Meigs2/Axis/README.md

# Axis

This project is unfinished and is under active development.

For updates, come join the discord: https://discord.gg/SSdEUZB4Xh
