Meigs2/Axis/hardware/pcbs/Axis_Base_Rev01/Axis_Base_Rev01.kicad_pcb

## KiCad design hardware/pcbs/Axis_Base_Rev01/Axis_Base_Rev01.kicad_pcb (2025-01-05)

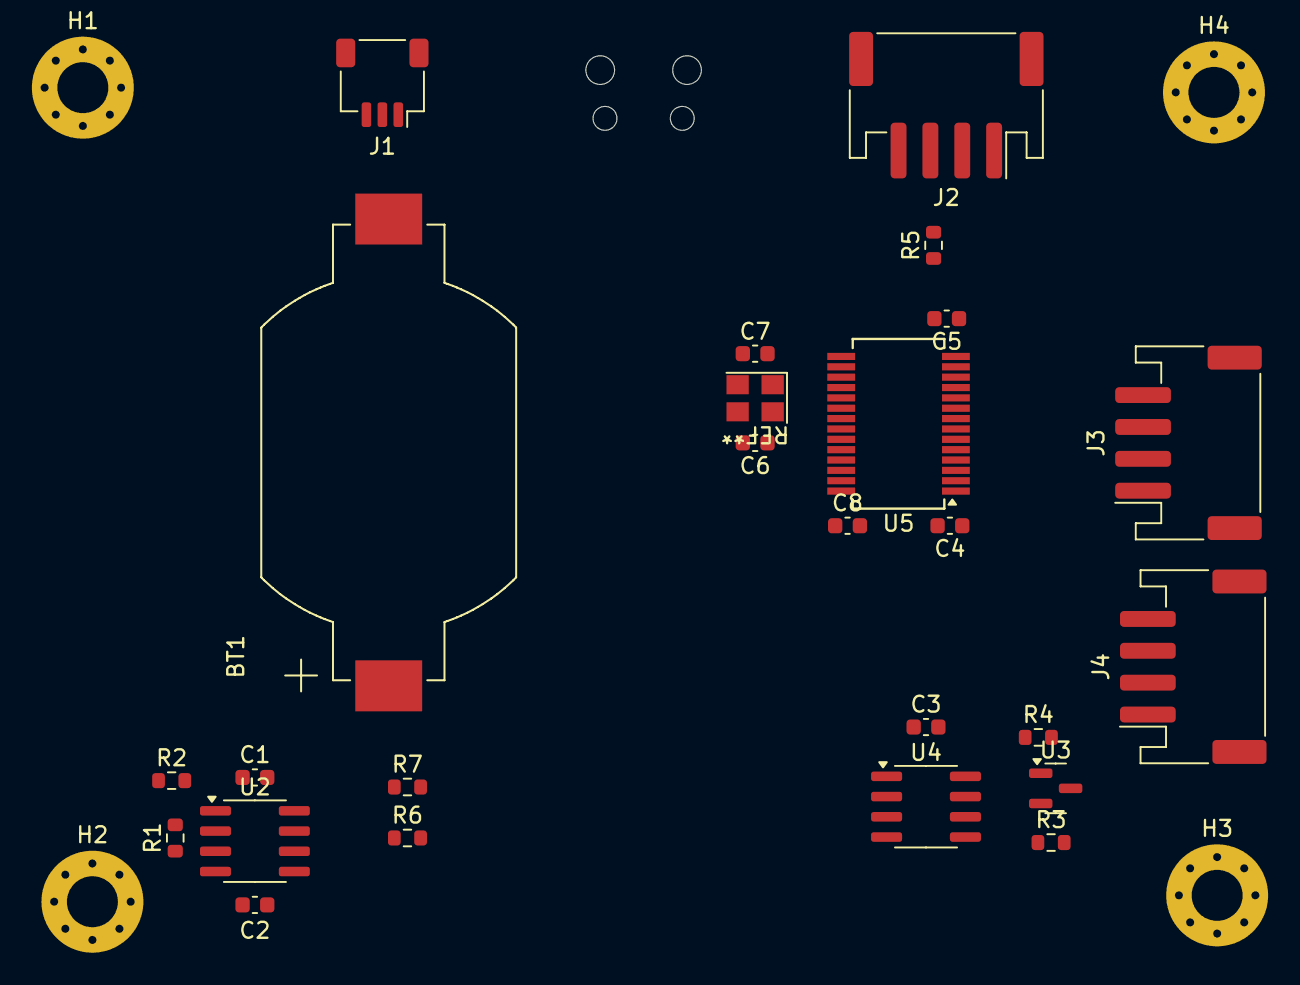
[picture p1: board Axis_Base_Rev01.kicad_pcb from above]

Board: 4 copper layers, 30 parts (1 on the bottom side), 28 nets, no tracks yet.

Parts:
BT1: BA2032; BAT_BU2032SM-BT-GTR
C1, C2, C3, C4, C5, C8: 0.1u; C_0603_1608Metric
C6, C7: 26p; C_0603_1608Metric
H1, H2, H3, H4: MountingHole; MountingHole_3.2mm_M3_Pad_Via
J1: SWD; JST_SH_SM03B-SRSS-TB_1x03-1MP_P1.00mm_Horizontal
J2: CAN_1; JST_PH_S4B-PH-SM4-TB_1x04-1MP_P2.00mm_Horizontal
J3: CAN_2; JST_PH_S4B-PH-SM4-TB_1x04-1MP_P2.00mm_Horizontal
J4: CAN_3; JST_PH_S4B-PH-SM4-TB_1x04-1MP_P2.00mm_Horizontal
R1, R2, R3, R4, R5, R6, R7: 1k; R_0603_1608Metric
U1: Pico; RPi_Pico_SMD_No_Silkscreen
U2: DS3231MZ; SOIC-8_3.9x4.9mm_P1.27mm
U3: DS2411R; SOT-23
U4: FM24CL16B; SOIC-8_3.9x4.9mm_P1.27mm
U5: MCP251863T-H; SSOP-28_5.3x10.2mm_P0.65mm
Y1: ABM8G-20.000MHZ-18-D2Y-T; Oscillator_Crystal_Abracon_SMD_ABM8G

Connections:
+3V3: C1.1, C3.1, C4.1, C5.1, R1.1, R2.1, R3.1, R6.1, R7.1, U1.36 (3V3_OUT), U2.2 (VCC), U3.2 (VIN), U4.8 (VDD), U5.1 (VIO), U5.14 (VDD)
+5V: C8.1, J2.1, J3.1, J4.1, U1.40 (VBUS), U5.25 (VCC)
+BATT: BT1.1 (+), C2.1, U2.6 (VBAT)
/1WIRE: R4.2, U1.26 (GPIO20)
/CANH: J2.2, J3.2, J4.2, R5.1, U5.4 (CANH)
/CANL: J2.3, J3.3, J4.3, R5.2, U5.3 (CANL)
/I2C0_SCL: R7.2, U1.22 (GPIO17), U2.8 (SCL), U4.6 (SCL)
/I2C0_SDA: R6.2, U1.21 (GPIO16), U2.7 (SDA), U4.5 (SDA)
/RTC_CLK: R1.2, U1.24 (GPIO18), U2.1 (32KHZ)
/SPI0_MISO: U1.1 (GPIO0), U5.11 (SDO)
/SPI0_MOSI: U1.5 (GPIO3), U5.10 (SDI)
/SPI0_SCK: U1.4 (GPIO2), U5.9 (SCK)
/STBY: U1.10 (GPIO7), U5.5 (STBY)
/SWCLK: J1.1, U1.41 (SWCLK)
/SWDIO: J1.3, U1.43 (SWDIO)
/~SPI0_CS: U1.2 (GPIO1), U5.13 (~CS)
/~TIMER_INT: R2.2, U1.25 (GPIO19), U2.3 (~INT/SQW)
/~nINT1: U1.7 (GPIO5), U5.6 (~nINT1)
/~nINT2: U1.9 (GPIO6), U5.7 (~nINT2)
/~nINT: U1.6 (GPIO4), U5.19 (~nINT)
GND: BT1.2 (-), C1.2, C2.2, C3.2, C4.2, C5.2, C8.2, J1.2, J2.4, J3.4, J4.4, U1.3 (GND), U1.8 (GND), U1.13 (GND), U1.18 (GND), U1.23 (GND), U1.28 (GND), U1.38 (GND), U1.42 (GND), U2.5 (GND), U3.3 (GND), U4.4 (VSS), U4.7 (WP), U5.22 (VSS), U5.24 (GND), Y1.1, Y1.3
unnamed: C6.2, Y1.4
unnamed: C7.2, Y1.2
unnamed: R3.2, R4.1, U3.1 (I/O)
unnamed: C7.1, U5.21 (OSC1)
unnamed: C6.1, U5.20 (OSC2)
unnamed: U5.16 (RxCAN), U5.28 (RXD)
unnamed: U5.15 (TxCAN), U5.23 (TXD)
