Meigs2/Axis/hardware/pcbs/Hats/Gaggia/Axis_GCP_Hat_Rev1/Axis_GCP_Hat_Rev1.kicad_pcb

## KiCad design hardware/pcbs/Hats/Gaggia/Axis_GCP_Hat_Rev1/Axis_GCP_Hat_Rev1.kicad_pcb (2024-10-21)

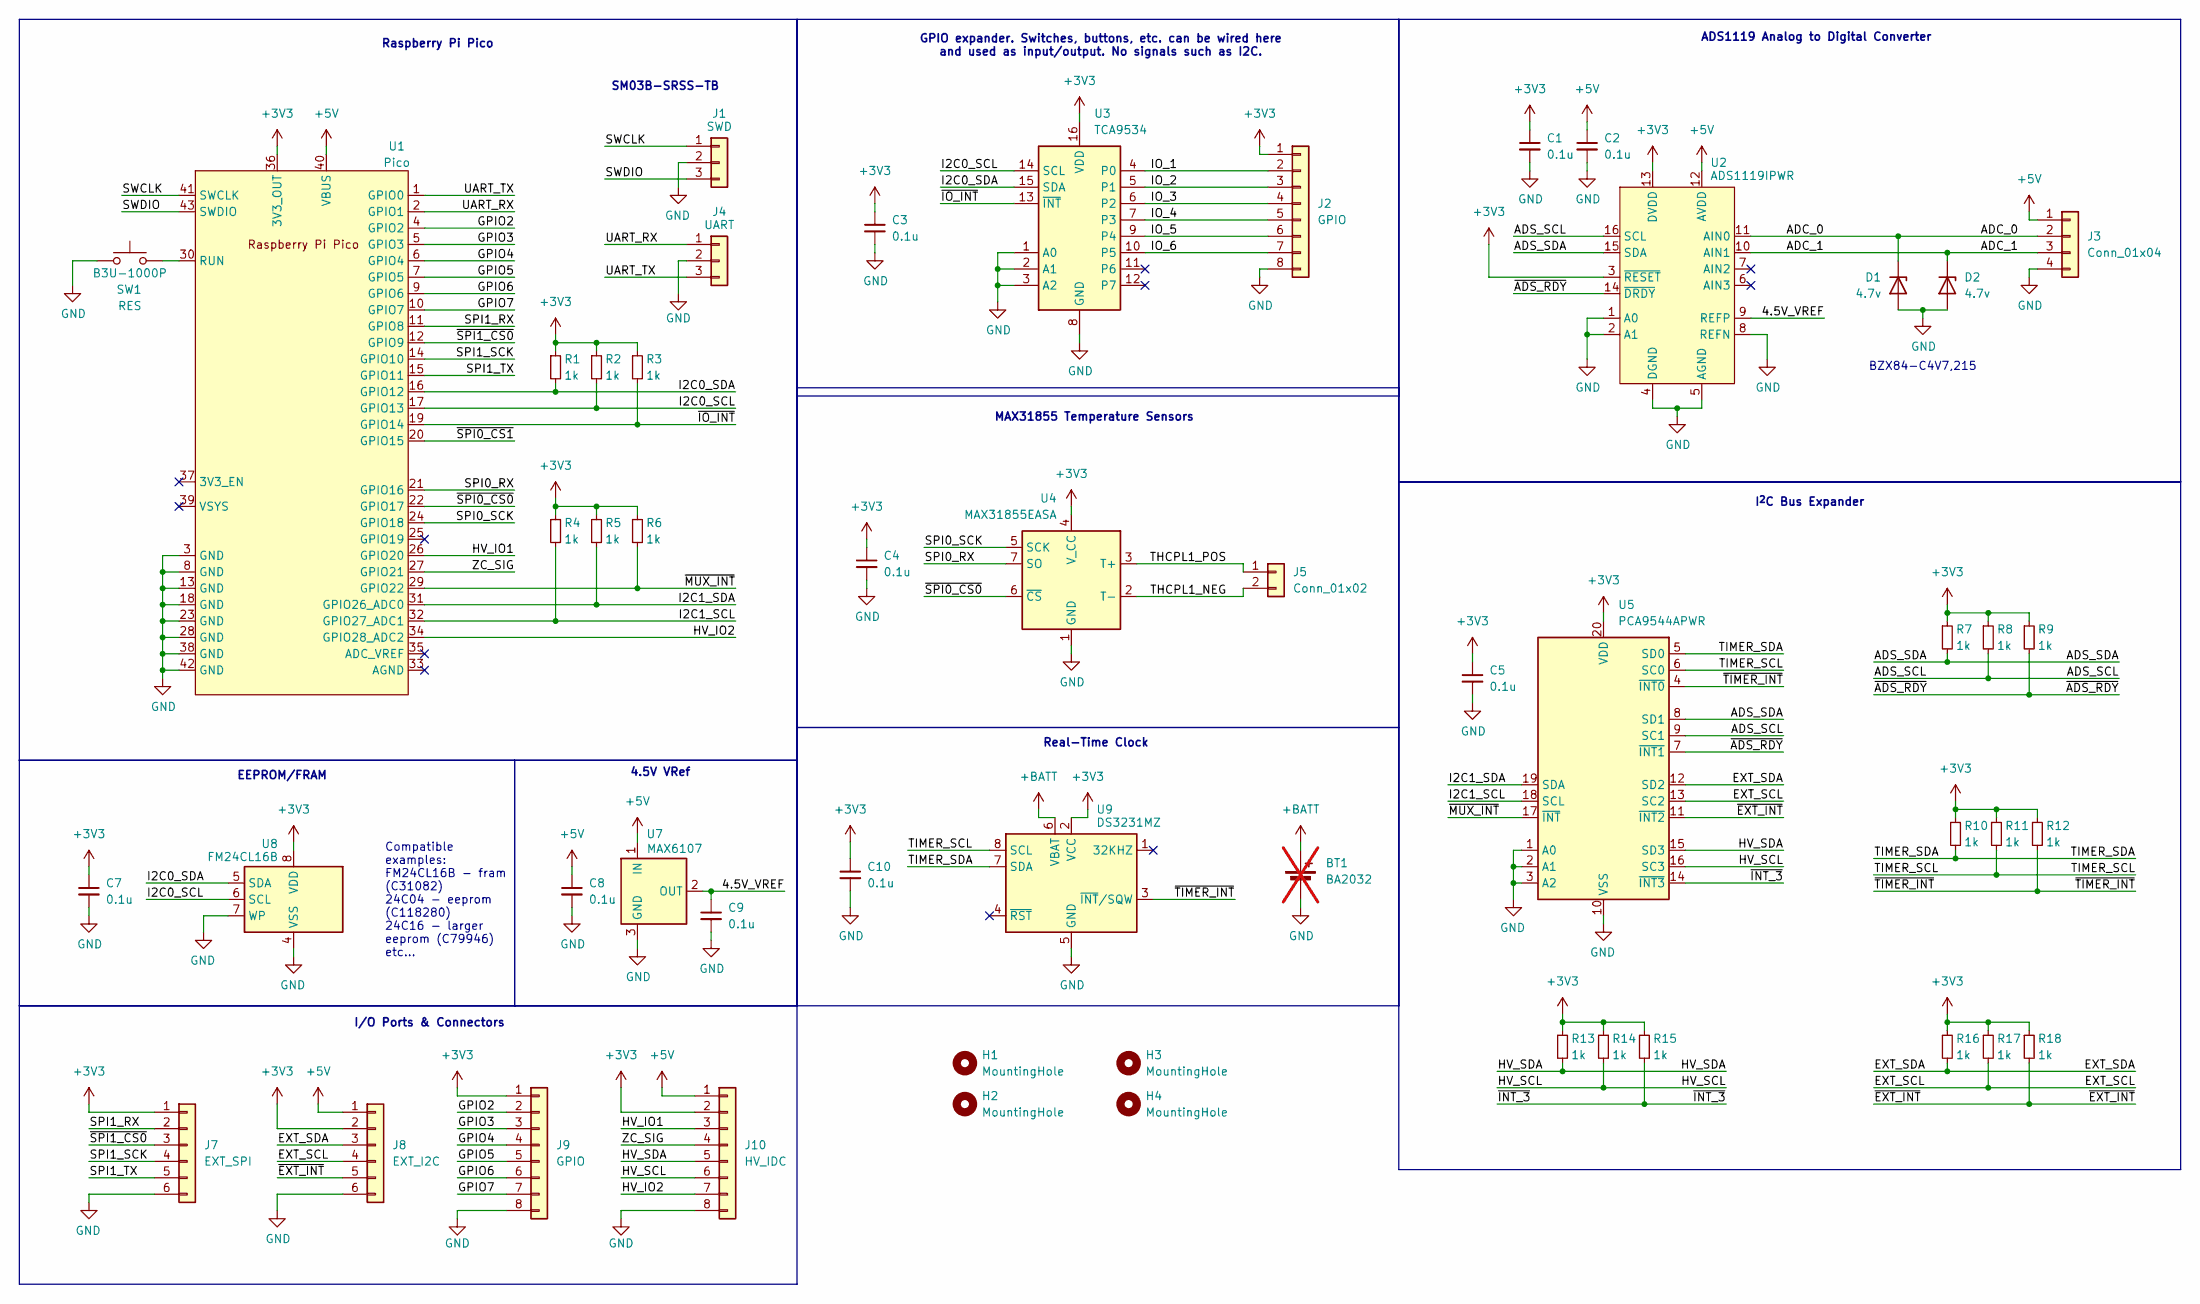
[picture p2: schematic Axis_GCP_Hat_Rev1.kicad_sch, Axis Control PCB]

Parts:
BT1: BA2032; not fitted
C1, C2, C3, C4, C5, C7, C8, C9, C10: 0.1u; C_0402_1005Metric
D1, D2: 4.7v; SOT-23
H1, H2, H3, H4: MountingHole; MountingHole_2.7mm_M2.5
J1: SWD; JST_SH_SM03B-SRSS-TB_1x03-1MP_P1.00mm_Horizontal
J2: GPIO; TerminalBlock_Phoenix_MKDS-1,5-8-5.08_1x08_P5.08mm_Horizont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
J3: Conn_01x04; TerminalBlock_Phoenix_MKDS-1,5-4-5.08_1x04_P5.08mm_Horizont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
J4: UART; JST_SH_SM03B-SRSS-TB_1x03-1MP_P1.00mm_Horizontal
J5: Conn_01x02; TerminalBlock_Phoenix_MKDS-1,5-2-5.08_1x02_P5.08mm_Horizont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
J7: EXT_SPI; PinHeader_1x06_P2.54mm_Vertical
J8: EXT_I2C; PinHeader_1x06_P2.54mm_Vertical
J9: GPIO; PinHeader_1x08_P2.54mm_Vertical
J10: HV_IDC; IDC-Header_2x04_P2.54mm_Vertical
R1, R2, R3, R4, R5, R6, R7, R8, R9, R10, R11, R12, R13, R14, R15, R16, R17, R18: 1k; R_0402_1005Metric
SW1: RES; SW_SPST_B3U-1000P; LCSC C231329
U1: Pico; RPi_Pico_SMD_TH_No_Silkscreen
U2: ADS1119IPWR; TSSOP-16_4.4x5mm_P0.65mm
U3: TCA9534; TSSOP-16_4.4x5mm_P0.65mm
U4: MAX31855EASA; SOIC-8_3.9x4.9mm_P1.27mm
U5: PCA9544APWR; TSSOP-20_4.4x6.5mm_P0.65mm
U7: MAX6107; SOT-23
U8: FM24CL16B; SOIC-8_3.9x4.9mm_P1.27mm; LCSC C31082
U9: DS3231MZ; SOIC-8_3.9x4.9mm_P1.27mm

Connections:
+3V3: C1.1, C3.1, C4.1, C5.1, C7.1, C10.1, J2.1, J7.1, J8.2, J9.1, J10.2, R1.1, R2.1, R3.1, R4.1, R5.1, R6.1, R7.1, R8.1, R9.1, R10.1, R11.1, R12.1, R13.1, R14.1, R15.1, R16.1, R17.1, R18.1, U1.36 (3V3_OUT), U2.3 (~RESET), U2.13 (DVDD), U3.16 (VDD), U4.4 (V_CC), U5.20 (VDD), U8.8 (VDD), U9.2 (VCC)
+5V: C2.1, C8.1, J3.1, J8.1, J10.1, U1.40 (VBUS), U2.12 (AVDD), U7.1 (IN)
+BATT: BT1.1 (+), U9.6 (VBAT)
/4.5V_VREF: C9.1, U2.9 (REFP), U7.2 (OUT)
/ADC_0: D1.1 (K), J3.2, U2.11 (AIN0)
/ADC_1: D2.1 (K), J3.3, U2.10 (AIN1)
/ADS_SCL: R8.2, U2.16 (SCL), U5.9 (SC1)
/ADS_SDA: R7.2, U2.15 (SDA), U5.8 (SD1)
/EXT_SCL: J8.4, R17.2, U5.13 (SC2)
/EXT_SDA: J8.3, R16.2, U5.12 (SD2)
/GPIO2: J9.2, U1.4 (GPIO2)
/GPIO3: J9.3, U1.5 (GPIO3)
/GPIO4: J9.4, U1.6 (GPIO4)
/GPIO5: J9.5, U1.7 (GPIO5)
/GPIO6: J9.6, U1.9 (GPIO6)
/GPIO7: J9.7, U1.10 (GPIO7)
/HV_IO1: J10.3, U1.26 (GPIO20)
/HV_IO2: J10.7, U1.34 (GPIO28_ADC2)
/HV_SCL: J10.6, R14.2, U5.16 (SC3)
/HV_SDA: J10.5, R13.2, U5.15 (SD3)
/I2C0_SCL: R2.2, U1.17 (GPIO13), U3.14 (SCL), U8.6 (SCL)
/I2C0_SDA: R1.2, U1.16 (GPIO12), U3.15 (SDA), U8.5 (SDA)
/I2C1_SCL: R4.2, U1.32 (GPIO27_ADC1), U5.18 (SCL)
/I2C1_SDA: R5.2, U1.31 (GPIO26_ADC0), U5.19 (SDA)
/IO_1: J2.2, U3.4 (P0)
/IO_2: J2.3, U3.5 (P1)
/IO_3: J2.4, U3.6 (P2)
/IO_4: J2.5, U3.7 (P3)
/IO_5: J2.6, U3.9 (P4)
/IO_6: J2.7, U3.10 (P5)
/SPI0_RX: U1.21 (GPIO16), U4.7 (SO)
/SPI0_SCK: U1.24 (GPIO18), U4.5 (SCK)
/SPI1_RX: J7.2, U1.11 (GPIO8)
/SPI1_SCK: J7.4, U1.14 (GPIO10)
/SPI1_TX: J7.5, U1.15 (GPIO11)
/SWCLK: J1.1, U1.41 (SWCLK)
/SWDIO: J1.3, U1.43 (SWDIO)
/THCPL1_NEG: J5.2, U4.2 (T-)
/THCPL1_POS: J5.1, U4.3 (T+)
/TIMER_SCL: R11.2, U5.6 (SC0), U9.8 (SCL)
/TIMER_SDA: R10.2, U5.5 (SD0), U9.7 (SDA)
/UART_RX: J4.1, U1.2 (GPIO1)
/UART_TX: J4.3, U1.1 (GPIO0)
/ZC_SIG: J10.4, U1.27 (GPIO21)
/~ADS_RDY: R9.2, U2.14 (~DRDY), U5.7 (~INT1)
/~EXT_INT: J8.5, R18.2, U5.11 (~INT2)
/~INT_3: R15.2, U5.14 (~INT3)
/~IO_INT: R3.2, U1.19 (GPIO14), U3.13 (~INT)
/~MUX_INT: R6.2, U1.29 (GPIO22), U5.17 (~INT)
/~SPI0_CS0: U1.22 (GPIO17), U4.6 (~CS)
/~SPI0_CS1: U1.20 (GPIO15)
/~SPI1_CS0: J7.3, U1.12 (GPIO9)
/~TIMER_INT: R12.2, U5.4 (~INT0), U9.3 (~INT/SQW)
GND: BT1.2 (-), C1.2, C2.2, C3.2, C4.2, C5.2, C7.2, C8.2, C9.2, C10.2, D1.2 (A), D2.2 (A), J1.2, J2.8, J3.4, J4.2, J7.6, J8.6, J9.8, J10.8, SW1.1, U1.3 (GND), U1.8 (GND), U1.13 (GND), U1.18 (GND), U1.23 (GND), U1.28 (GND), U1.38 (GND), U1.42 (GND), U2.1 (A0), U2.2 (A1), U2.4 (DGND), U2.5 (AGND), U2.8 (REFN), U3.1 (A0), U3.2 (A1), U3.3 (A2), U3.8 (GND), U4.1 (GND), U5.1 (A0), U5.2 (A1), U5.3 (A2), U5.10 (VSS), U7.3 (GND), U8.4 (VSS), U8.7 (WP), U9.5 (GND)
unnamed: SW1.2, U1.30 (RUN)

Notes on the sheet:
BZX84-C4V7,215
I^{2}C Bus Expander
I/O Ports & Connectors
Raspberry Pi Pico
Compatible examples: FM24CL16B - fram (C31082) 24C04 - eeprom (C118280) 24C16 - larger eeprom (C79946) etc...
EEPROM/FRAM
ADS1119 Analog to Digital Converter
Real-Time Clock
MAX31855 Temperature Sensors
GPIO expander. Switches, buttons, etc. can be wired here and used as input/output. No signals such as I2C.
4.5V VRef
SM03B-SRSS-TB

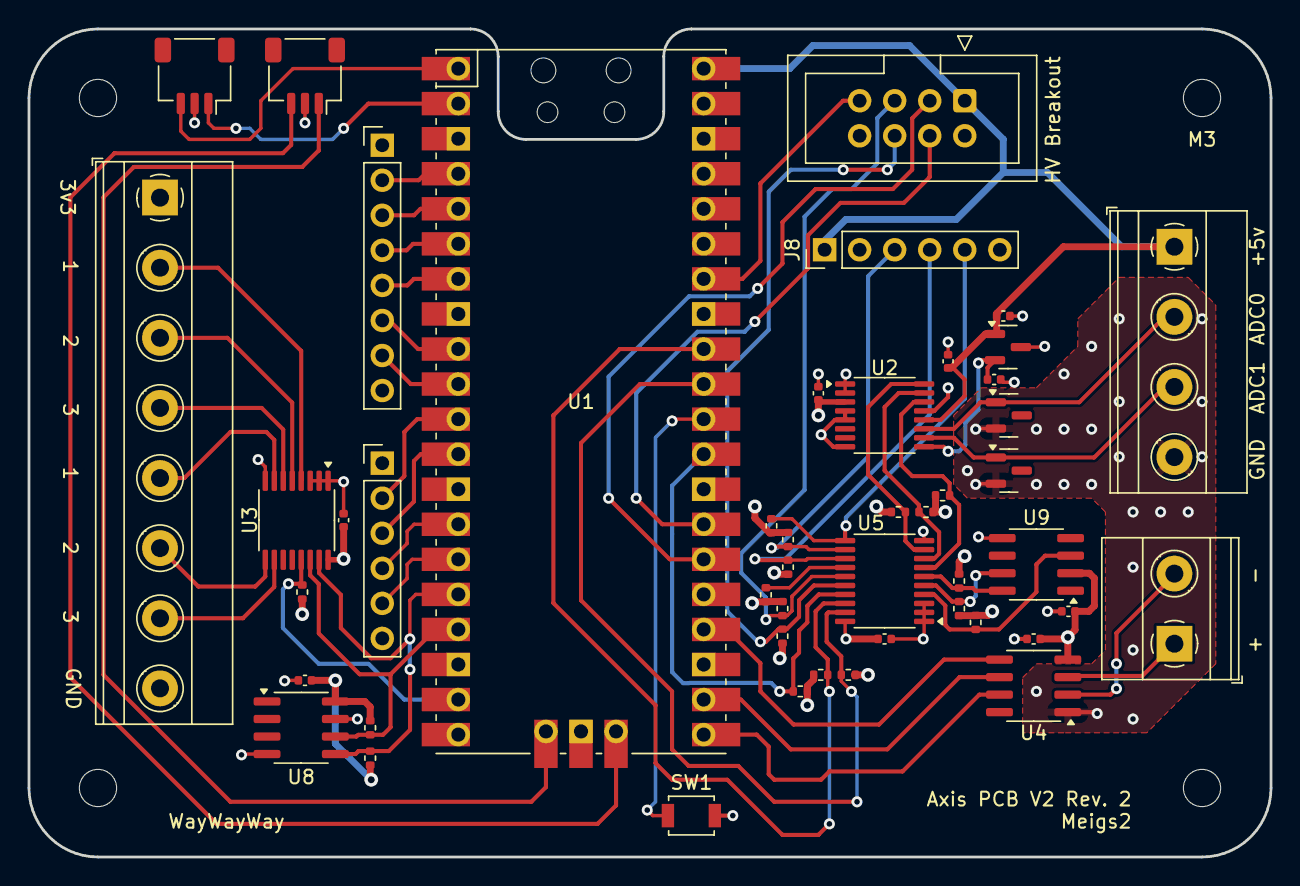
[picture p3: board Axis_GCP_Hat_Rev1.kicad_pcb from above]

Board: 4 copper layers, 90.0 x 60.0 mm, 51 parts (0 on the bottom side), 53 nets.
