Meigs2/Axis/hardware/pcbs/Axis_V2_HV/Axis_V2_HV.kicad_pcb

## KiCad design hardware/pcbs/Axis_V2_HV/Axis_V2_HV.kicad_pcb (2024-10-12)

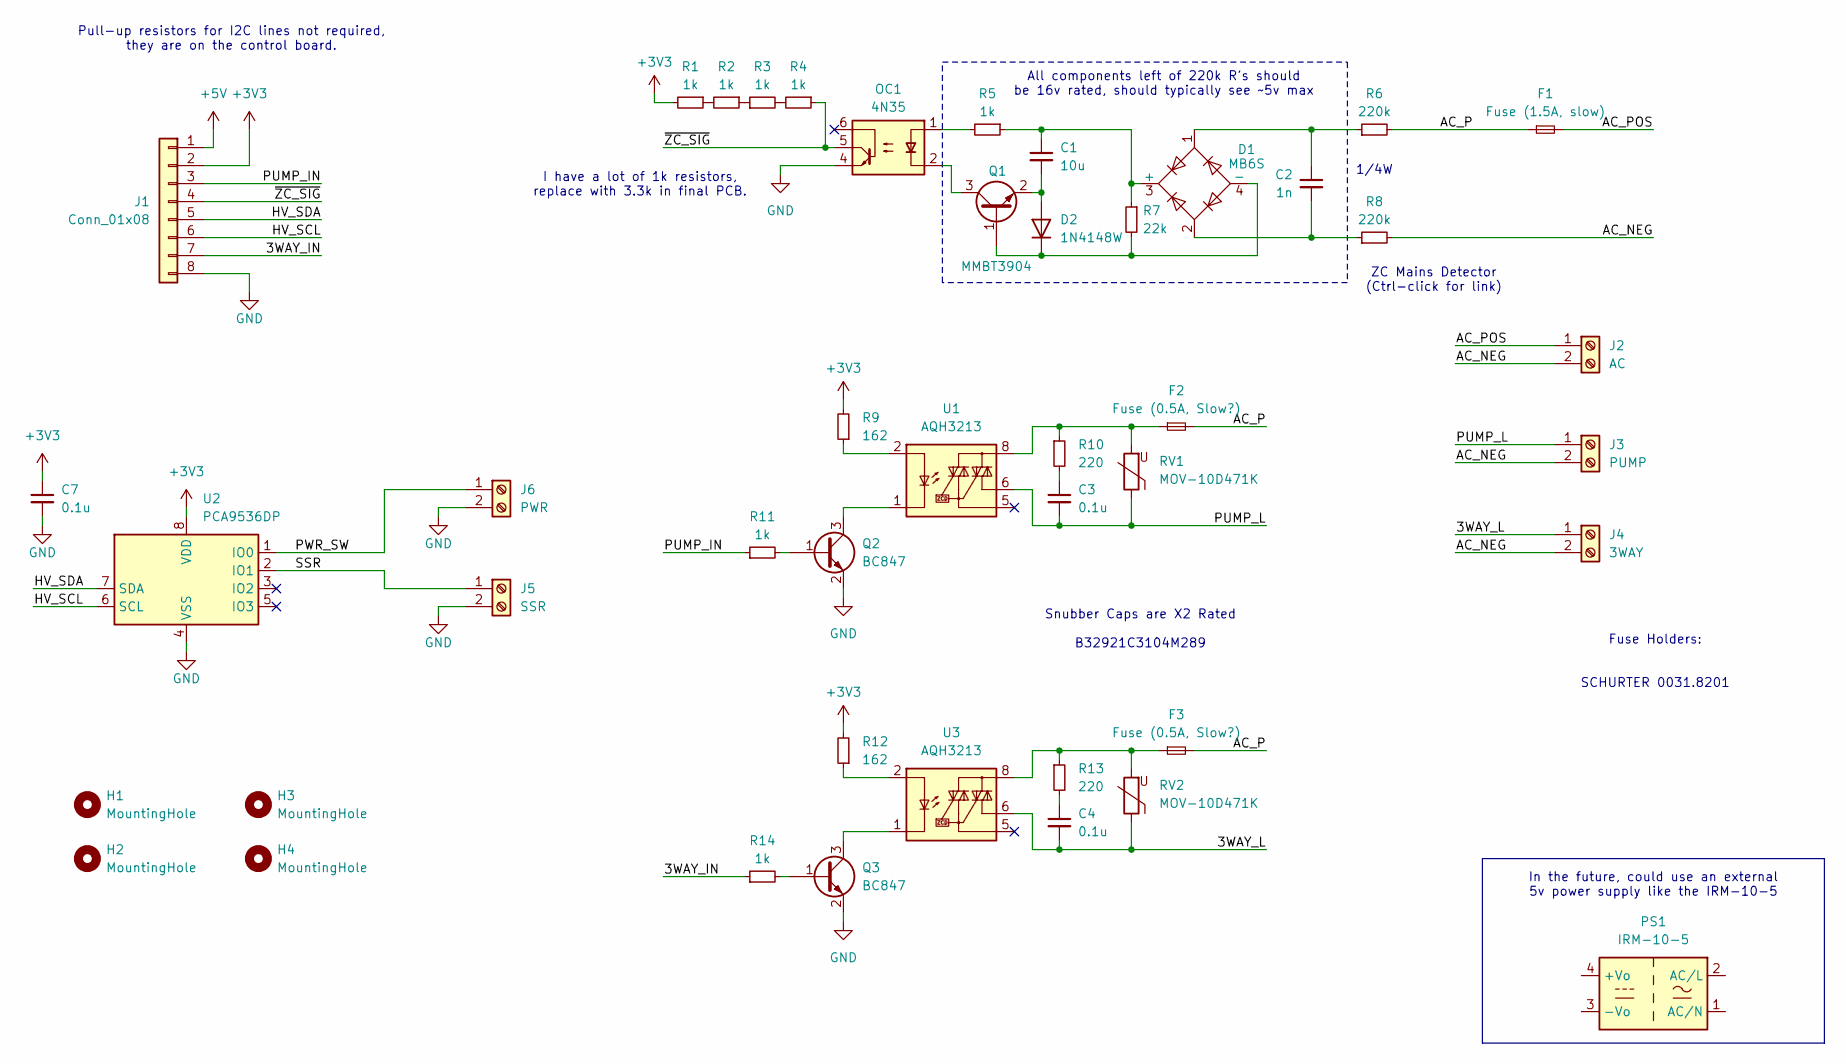
[picture p4: schematic Axis_V2_HV.kicad_sch]

Parts:
C1: 10u; C_1206_3216Metric
C2: 1n; C_1206_3216Metric
C3, C4: 0.1u; C_Rect_L13.0mm_W6.0mm_P10.00mm_FKS3_FKP3_MKS4
C7: 0.1u; C_0402_1005Metric
D1: MB6S; TO-269AA
D2: 1N4148W; D_SOD-123
F1: Fuse (1.5A, slow); Fuseholder_Cylinder-5x20mm_Schurter_0031_8201_Horizontal_Op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
F2, F3: Fuse (0.5A, Slow?); Fuseholder_Cylinder-5x20mm_Schurter_0031_8201_Horizontal_Op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
H1, H2, H3, H4: MountingHole; MountingHole_2.7mm_M2.5
J1: Conn_01x08; IDC-Header_2x04_P2.54mm_Vertical
J2: AC; TerminalBlock_Phoenix_MKDS-1,5-2-5.08_1x02_P5.08mm_Horizont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
J3: PUMP; TerminalBlock_Phoenix_MKDS-1,5-2-5.08_1x02_P5.08mm_Horizont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
J4: 3WAY; TerminalBlock_Phoenix_MKDS-1,5-2-5.08_1x02_P5.08mm_Horizont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
J5: SSR; TerminalBlock_Phoenix_MKDS-1,5-2-5.08_1x02_P5.08mm_Horizont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
J6: PWR; TerminalBlock_Phoenix_MKDS-1,5-2-5.08_1x02_P5.08mm_Horizont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
OC1: 4N35; SMDIP-6_W7.62mm
PS1: IRM-10-5; Converter_ACDC_MeanWell_IRM-10-xx_THT
Q1: MMBT3904; SOT-23
Q2, Q3: BC847; SOT-23
R1, R2, R3, R4, R11, R14: 1k; R_0402_1005Metric
R5: 1k; R_1206_3216Metric
R6, R8: 220k; R_Axial_DIN0207_L6.3mm_D2.5mm_P10.16mm_Horizontal
R7: 22k; R_1206_3216Metric
R9, R12: 162; R_0603_1608Metric
R10, R13: 220; R_Axial_DIN0207_L6.3mm_D2.5mm_P10.16mm_Horizontal
RV1, RV2: MOV-10D471K; RV_Disc_D12mm_W7.5mm_P7.5mm
U1, U3: AQH3213; DIP-8-N7_W7.62mm
U2: PCA9536DP; TSSOP-8_3x3mm_P0.65mm

Connections:
+3V3: C7.1, J1.2, R1.2, R9.2, R12.2, U2.8 (VDD)
+5V: J1.1
/3WAY_IN: J1.7, R14.1
/3WAY_L: C4.2, J4.1, RV2.1, U3.6
/AC_NEG: J2.2, J3.2, J4.2, R8.2
/AC_P: F1.1, F2.2, F3.2, R6.2
/AC_POS: F1.2, J2.1
/HV_SCL: J1.6, U2.6 (SCL)
/HV_SDA: J1.5, U2.7 (SDA)
/PUMP_IN: J1.3, R11.1
/PUMP_L: C3.2, J3.1, RV1.1, U1.6
/PWR_SW: J6.1, U2.1 (IO0)
/SSR: J5.1, U2.2 (IO1)
/~ZC_SIG: J1.4, OC1.5, R4.1
GND: C7.2, J1.8, J5.2, J6.2, OC1.4, Q2.2 (E), Q3.2 (E), U2.4 (VSS)
unnamed: C2.1, D1.1, R6.1
unnamed: C2.2, D1.2, R8.1
unnamed: C3.1, R10.2
unnamed: C4.1, R13.2
unnamed: C1.1, D1.3 (+), R5.1, R7.1
unnamed: D1.4 (-), D2.1 (K), Q1.1 (B), R7.2
unnamed: C1.2, D2.2 (A), Q1.2 (E)
unnamed: F2.1, R10.1, RV1.2, U1.8
unnamed: F3.1, R13.1, RV2.2, U3.8
unnamed: OC1.1, R5.2
unnamed: OC1.2, Q1.3 (C)
unnamed: Q2.1 (B), R11.2
unnamed: Q2.3 (C), U1.1, U1.3, U1.4
unnamed: Q3.1 (B), R14.2
unnamed: Q3.3 (C), U3.1, U3.3, U3.4
unnamed: R1.1, R2.2
unnamed: R2.1, R3.1
unnamed: R3.2, R4.2
unnamed: R9.1, U1.2
unnamed: R12.1, U3.2

Notes on the sheet:
Pull-up resistors for I2C lines not required, they are on the control board.
I have a lot of 1k resistors, replace with 3.3k in final PCB.
ZC Mains Detector (Ctrl-click for link)
1/4W
In the future, could use an external 5v power supply like the IRM-10-5
All components left of 220k R's should be 16v rated, should typically see ~5v max
Fuse Holders: SCHURTER 0031.8201
Snubber Caps are X2 Rated B32921C3104M289

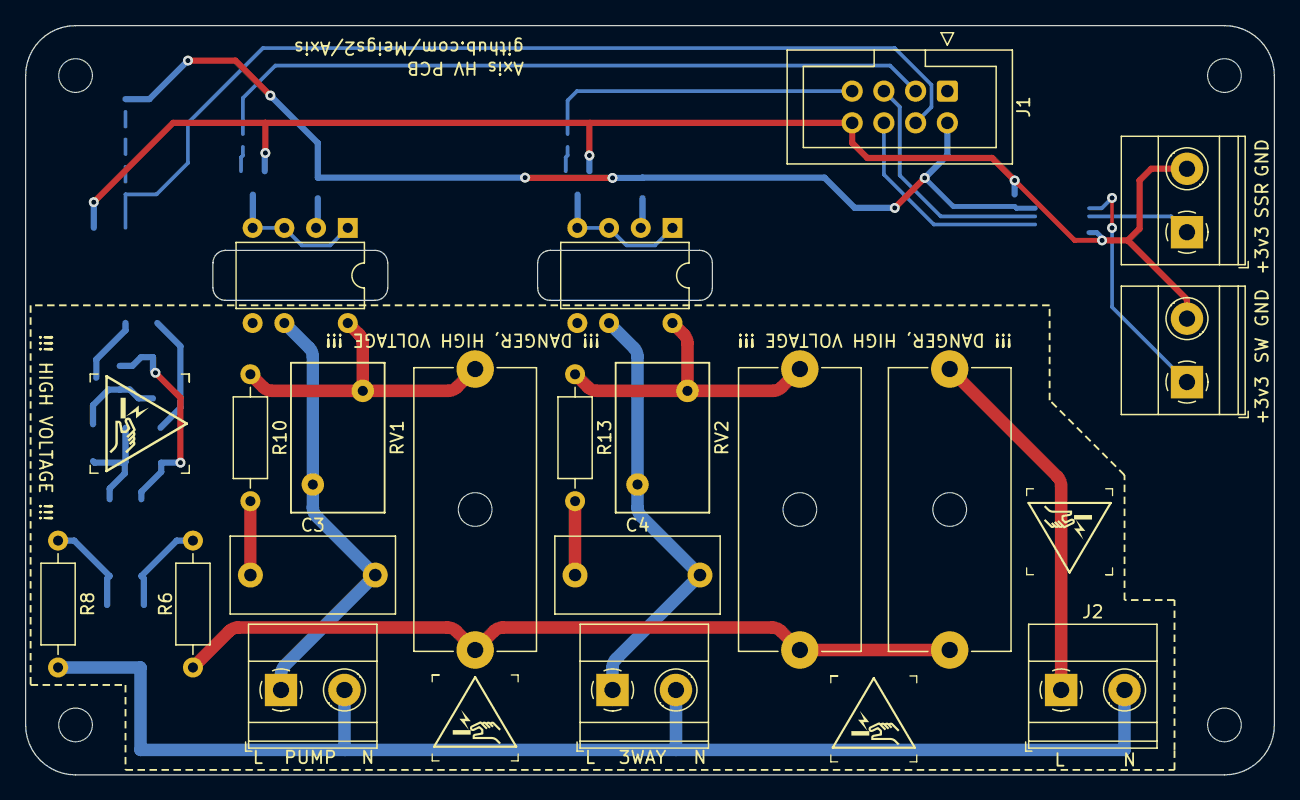
[picture p5: board Axis_V2_HV.kicad_pcb from above]

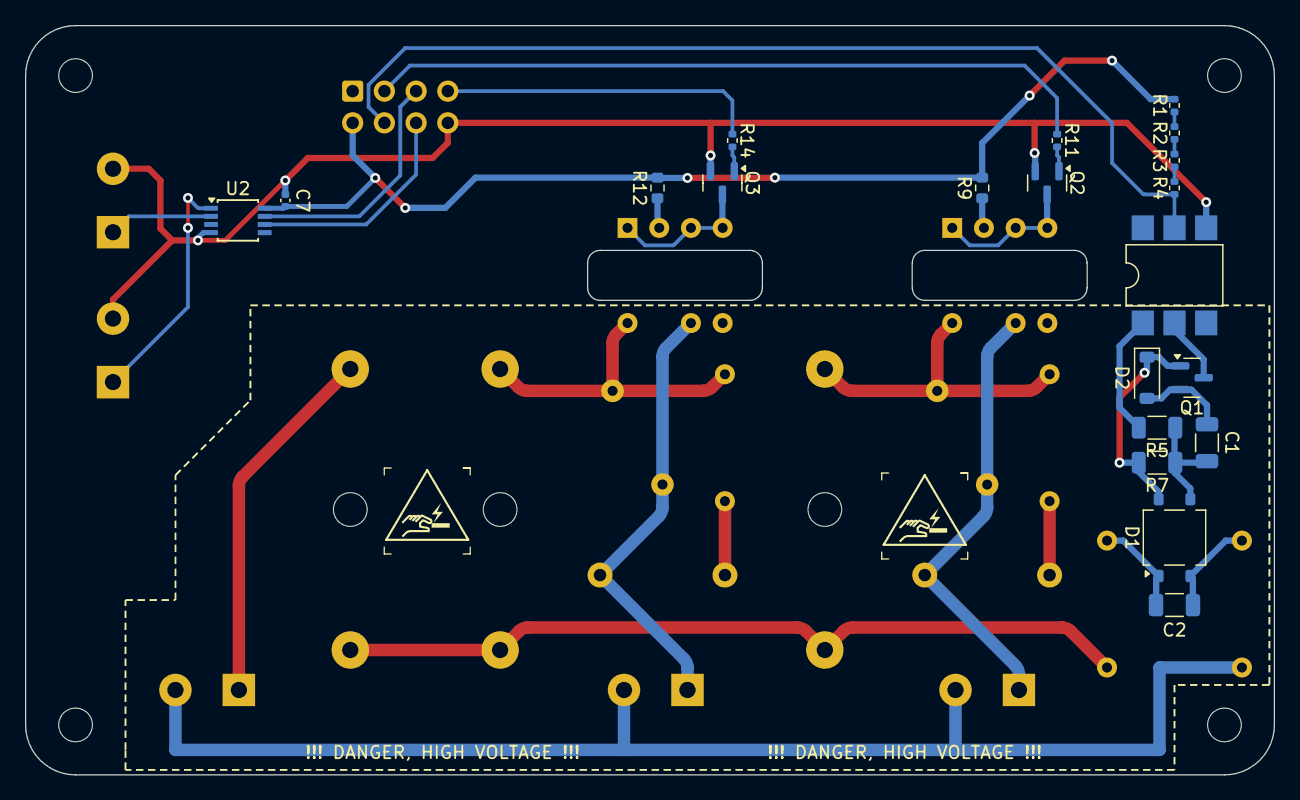
[picture p6: board Axis_V2_HV.kicad_pcb from below]

Board: 2 copper layers, 100.0 x 60.0 mm, 43 parts (20 on the bottom side), 34 nets.
