Meigs2/Axis/(commit log)

2023-07-04 Updates, fried the last temerature board lmao
2023-07-06 Change SPI frequency
2023-07-09 Updates, realizing I cant use either device as a spi slave. Will prob go over usb at this point.
2023-07-21 Pressure sensor working, roll back max changes
2023-07-29 Switch to using chart.js from d3, added ads observable.
2023-07-29 Move project from WASM to server-side Blazor (can't interact with GPIO in WASM), add charting for Temperature and Pressure readouts.
2023-07-30 Adding a bunch of stuff, going to separate out peripherals, sensors and controllers to hopefully organize the code and make things maintainable.
2023-08-05 ... something broken on core 1, great
    [main.rs]
2023-08-06 yeah so uh, stuff stopped working and I'm having to fix stuff in embassy-rs so we're going back to "just get it to work"
    [main.rs]
2023-08-06 Cleanup, pin version to custom version of embassy with fix for sending USB between threads.
    [client_communicator.rs, main.rs]
2023-08-06 Well. Fixed a bunch of stuff. Turns out you really gotta make all that stuff static. idk.
    [client_communicator.rs, main.rs]
2023-08-06 We're working, for some reason you can't run the usb device on core1, you have to run it on core0.
2023-08-07 Add some debugging to the pump dimmer and fix the dimmer staying on constantly.
    [main.rs]
2023-08-07 Cargo fix + fmt
    [client_communicator.rs, main.rs]
2023-10-28 Add axis pcb files
    [Axis_V1.kicad_pcb, Axis_V1.kicad_sch]
2023-10-28 Updates, add Pico MCU from github
    [Axis_V1.kicad_pcb, Axis_V1.kicad_sch, Pico.skp, Test.kicad_pcb, Test.kicad_sch]
2023-10-29 Add more stuff for pcb
    [197054003.stp, Axis_V1.kicad_pcb, Axis_V1.kicad_sch, VOL617A-3X001T.step]
2023-10-29 PCB Updates
    [Axis_Simulation.kicad_pcb, Axis_Simulation.kicad_sch, Axis_V1.kicad_pcb, Axis_V1.kicad_sch]
2023-11-04 More pcb updates
    [Axis_V1.kicad_pcb, Axis_V1.kicad_sch]
2023-11-04 We're basically there, going to get BOM together.
    [Axis_V1.kicad_pcb, Axis_V1.kicad_sch]
2023-11-11 V1 updates
    [Axis_V1.kicad_pcb, Axis_V1.kicad_sch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]
2023-11-27 More updates I guess
    [Axis_V1.kicad_pcb]
2023-12-26 More and more pcb updates
    [Axis_V1.kicad_pcb, Axis_V1.kicad_sch]
2023-12-26 More changes
    [Axis_V1.kicad_pcb]
2023-12-26 Updates again
    [Axis_V1.kicad_pcb]
2023-12-27 v1.1 ordered, updates
    [Axis_V1.kicad_pcb, Axis_V1.kicad_sch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]
2023-12-27 Almost messed it up.
    Moved things around and make sure the rust code and schematics match up.
    [Axis_V1.kicad_pcb, Axis_V1.kicad_sch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]
2024-02-10 schematic updates
    [Axis_V1.kicad_sch]
2024-09-01 Updates to V2 pcb, add HV pcb
    [Axis_V2.kicad_sch, Axis_V2_HV.kicad_pcb, Axis_V2_HV.kicad_sch, high_voltage.kicad_sch, peripherals.kicad_sch]
2024-09-05 More changes, wow! Who would have thought?
    [Axis_V2.kicad_pcb, Axis_V2.kicad_sch, Axis_V2_HV.kicad_sch]
2024-09-07 More updates and changes
    [Axis_V2.kicad_sch, Axis_V2_HV.kicad_sch]
2024-09-07 Added a I2C expander for non-essential peripherals, etc.
    [Axis_V2.kicad_pcb, Axis_V2.kicad_sch]
2024-09-08 Almost done with v2, getting design review
    [Axis_V2.kicad_pcb, Axis_V2.kicad_sch]
2024-09-08 Remove old PCB files
    [197054003.stp, Axis MCU.kicad_pcb, Axis MCU.kicad_sch, Axis_Simulation.kicad_pcb, Axis_Simulation.kicad_sch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]
2024-09-28 Add "V3"
    [Axis_MCU_V3-B_Cu.gbl, Axis_MCU_V3-B_Mask.gbs, Axis_MCU_V3-B_Paste.gbp, Axis_MCU_V3-B_Silkscreen.gbo, Axis_MCU_V3-Edge_Cuts.gm1, Axis_MCU_V3-F_Cu.gtl, Axis_MCU_V3-F_Mask.gts, Axis_MCU_V3-F_Paste.gtp]
2024-09-28 Updates to the HV pcb
    [Axis_V2_HV.kicad_pcb, Axis_V2_HV.kicad_sch]
2024-09-28 Oops haha changes
    [Axis_V2_HV.kicad_sch]
2024-09-29 Is anyone listening anymore?
    [Axis_V2_HV.kicad_pcb, Axis_V2_HV.kicad_sch]
2024-09-29 Yuuuuuuuuuuuuuuuuuup, nobody's here
    [Axis_V2_HV.kicad_pcb, Axis_V2_HV.kicad_sch]
2024-10-05 Ok I'm about to order the HV pcb and parts somebody stop me
    [Axis_V2_HV.kicad_pcb, Axis_V2_HV.kicad_sch]
2024-10-21 Rev 3 Update or something
    [Axis_MCU_V3-B_Cu.gbl, Axis_MCU_V3-B_Mask.gbs, Axis_MCU_V3-B_Paste.gbp, Axis_MCU_V3-B_Silkscreen.gbo, Axis_MCU_V3-Edge_Cuts.gm1, Axis_MCU_V3-F_Cu.gtl, Axis_MCU_V3-F_Mask.gts, Axis_MCU_V3-F_Paste.gtp]
2024-12-21 Add V4 pcb
    [Axis_MCU_V4-B_Cu.gbl, Axis_MCU_V4-B_Mask.gbs, Axis_MCU_V4-B_Paste.gbp, Axis_MCU_V4-B_Silkscreen.gbo, Axis_MCU_V4-Edge_Cuts.gm1, Axis_MCU_V4-F_Cu.gtl, Axis_MCU_V4-F_Mask.gts, Axis_MCU_V4-F_Paste.gtp]
2024-12-24 Add base board
    [Axis_Base_Rev01-B_Cu.gbl, Axis_Base_Rev01-B_Mask.gbs, Axis_Base_Rev01-B_Paste.gbp, Axis_Base_Rev01-B_Silkscreen.gbo, Axis_Base_Rev01-Edge_Cuts.gm1, Axis_Base_Rev01-F_Cu.gtl, Axis_Base_Rev01-F_Mask.gts, Axis_Base_Rev01-F_Paste.gtp]
